samuel-ellison/Horizontal-Platform-Mechanism/README.md

# Horizontal-Platform-Mechanism
MECH&AE 162A - Introduction to Mechanisms and Mechanical Systems - Final Project - UCLA 2019

Professor Majlessi

This is NOT to be used for future students trying to complete the class. The purpose is to backup my work and for fututre reference.
