samuel-ellison/Horizontal-Platform-Mechanism/Ellison_Samuel_Report_Fall2019.pdf

Samuel Ellison
204977052
12/13/2019

## MAE 162A Final Project: Horizontal Platform Mechanism

(1) Mechanism Dimensions

The Horizontal Platform Mechanism is composed of two main vector loops: a four-bar linkage on the left, and another loop to describe the rest of the mechanism’s linkages. The first step in determining the dimensions was to look at the four-bar linkage. Taken alone, this kinematic chain resembles a Chebyshev linkage, of which the ratios of all links are proportionally related. The purpose and advantage of a Chebyshev linkage is that it will keep the midpoint of the coupler (link
3) vertically stable for a range of input angles. Therefore, if this linkage is used, the left leg of the platform will be satisfied. The appropriate ratios for a Chebyshev linkage are:

r1: r2: r3 = 4: 5: 2

and r2 = r4. Specifying any of these lengths will define the others. I chose to specify r1 = 810mm to fit within the 850mm horizontal limit at the bottom. The four bar Chebyshev linkage is then:

r1 = 810mm, r2 = r4 = 1012.5mm, r3 = 405mm

The Chebyshev linkage was constructed as a sketch in SolidWorks. The rest of the mechanism was added to the sketch and experimented with until the platform appeared to stay flat over a range of input angles. See the sketch and assembly construction of the mechanism below:

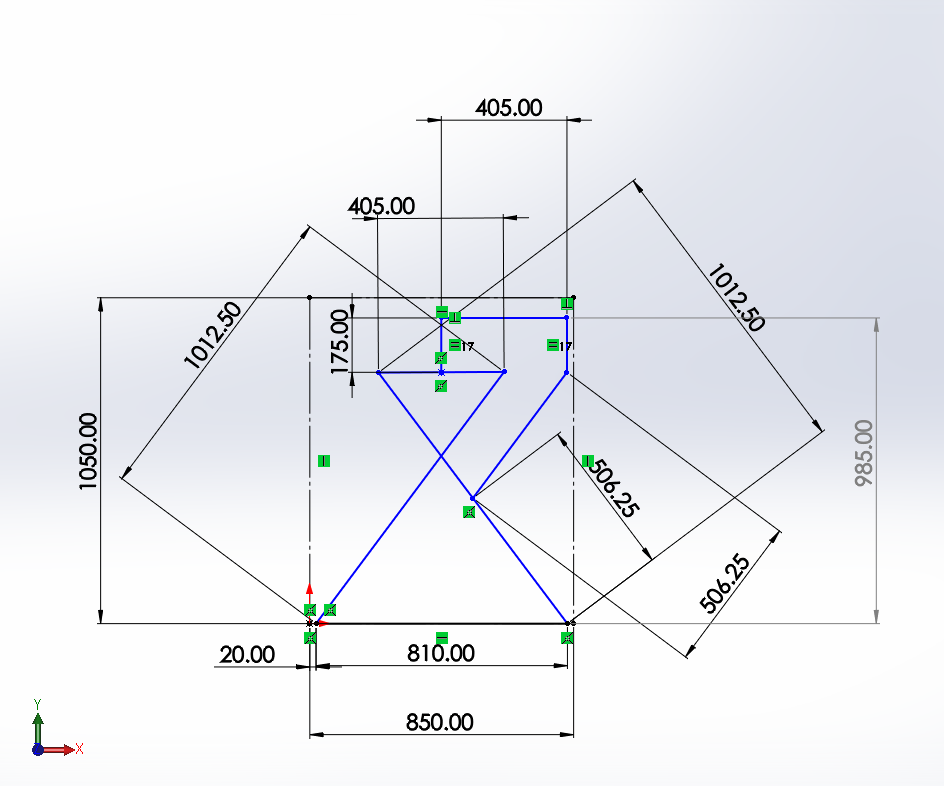
[picture p1: figure]

Figure 1: One Dimensional Sketch of Mechanism. All dimensions are in millimeters and were made into 3D linkages to the right. Note that link 5 bisects link 4 and is half its length, and that the length of the platform is the same as link 3.

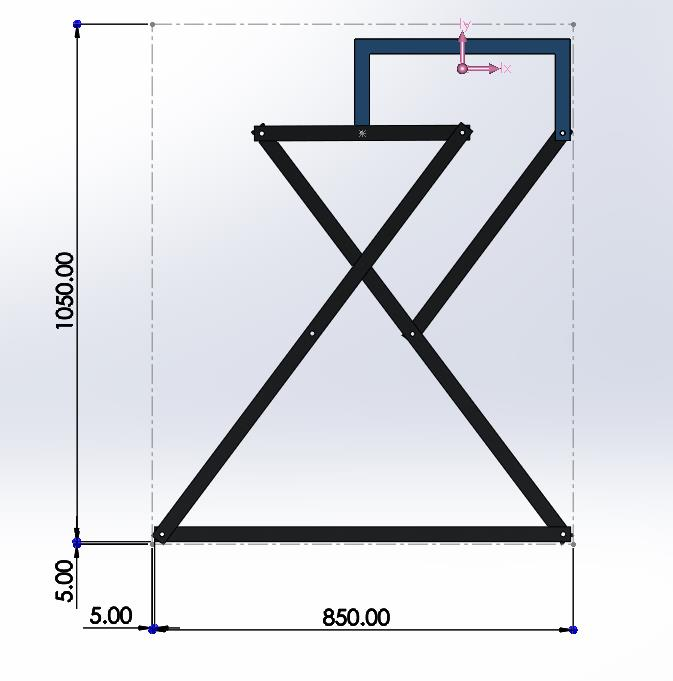
[picture p2: figure]

Figure 2: Planar View of 3D model of Mechanism. The Center of Mass of the Tabletop is shown as the pink origin. The rectangular outline encloses the entire mechanism for this position. Each link has a thickness and width of 30mm.

(2) The range of the input angle [θ2,min, θ2,max] was determined through trial and error. The angle was varied within the sketch (Figure 1) until the tabletop began to displace vertically/angularly. The range was entered into MATLAB to check the displacements to see if requirements were met (i.e. vertical displacement < 4mm, horizontal displacement > 850 mm). An ideal (but not unique) range was found to be:

θ2 = [36.87°, 96°]

θ2,min corresponds to the position at which the Chebyshev coupler and opposite leg are both oriented vertically, i.e. θ2,min = cos⁻¹

(

r1
r2

) = cos⁻¹

(

4
5

)

The entire Mechanism can be described with these two vector loops shown below:

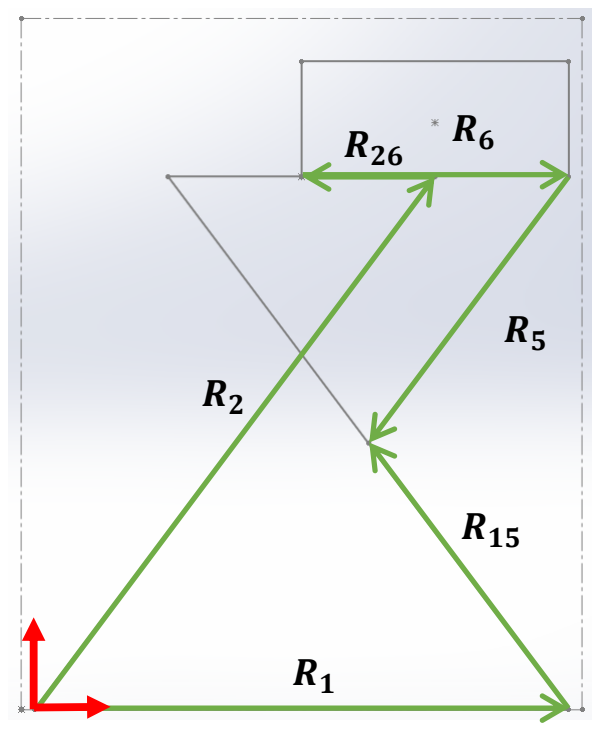
[picture p3: figure]
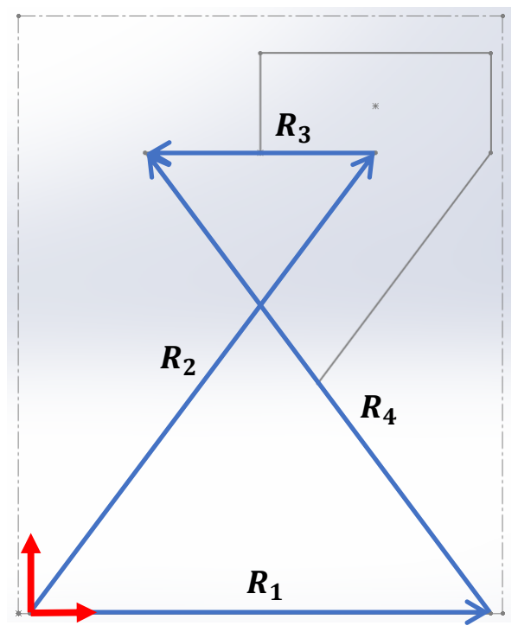
[picture p4: figure]

R2 + R3 − R4 − R1 = 0 | R2 + R26 + R6 + R5 − R15 − R1 = 0
r1 | r2 | r3 | r4 | r5 | r6 | r26 | r15
810mm | 1012.5mm | 405mm | 1012.5mm | 506.25mm | 405mm | C1 | C2
θ1 | θ2 | θ3 | θ4 | θ5 | θ6 | θ26 | θ15
0° | Input | Unknown | Unknown | Unknown | Unknown | C3 | C4

Where the Constraints are:

C1: | r26 = 0.5r3 | C2: | r15 = 0.5r15 | C3: | θ26 = θ3 | C4: | θ15 = θ4

Thus, a system of four equations and four unknowns was constructed and solved using MATLAB for every position of the input angle over its interval. Two separate Newton’s method iterations are used; the first uses the first vector loop to determine θ3 and θ4, and the second uses these values and determines θ5 and θ6. However, this is not sufficient to determine the displacement of the platform’s center of mass.

Once the position of the platform’s center of mass was determined, a new vector with constant properties was used to find its location from the endpoint of R26. See the appendix for a more detailed computation of the center of mass. The plots below illustrate the platform’s movements.

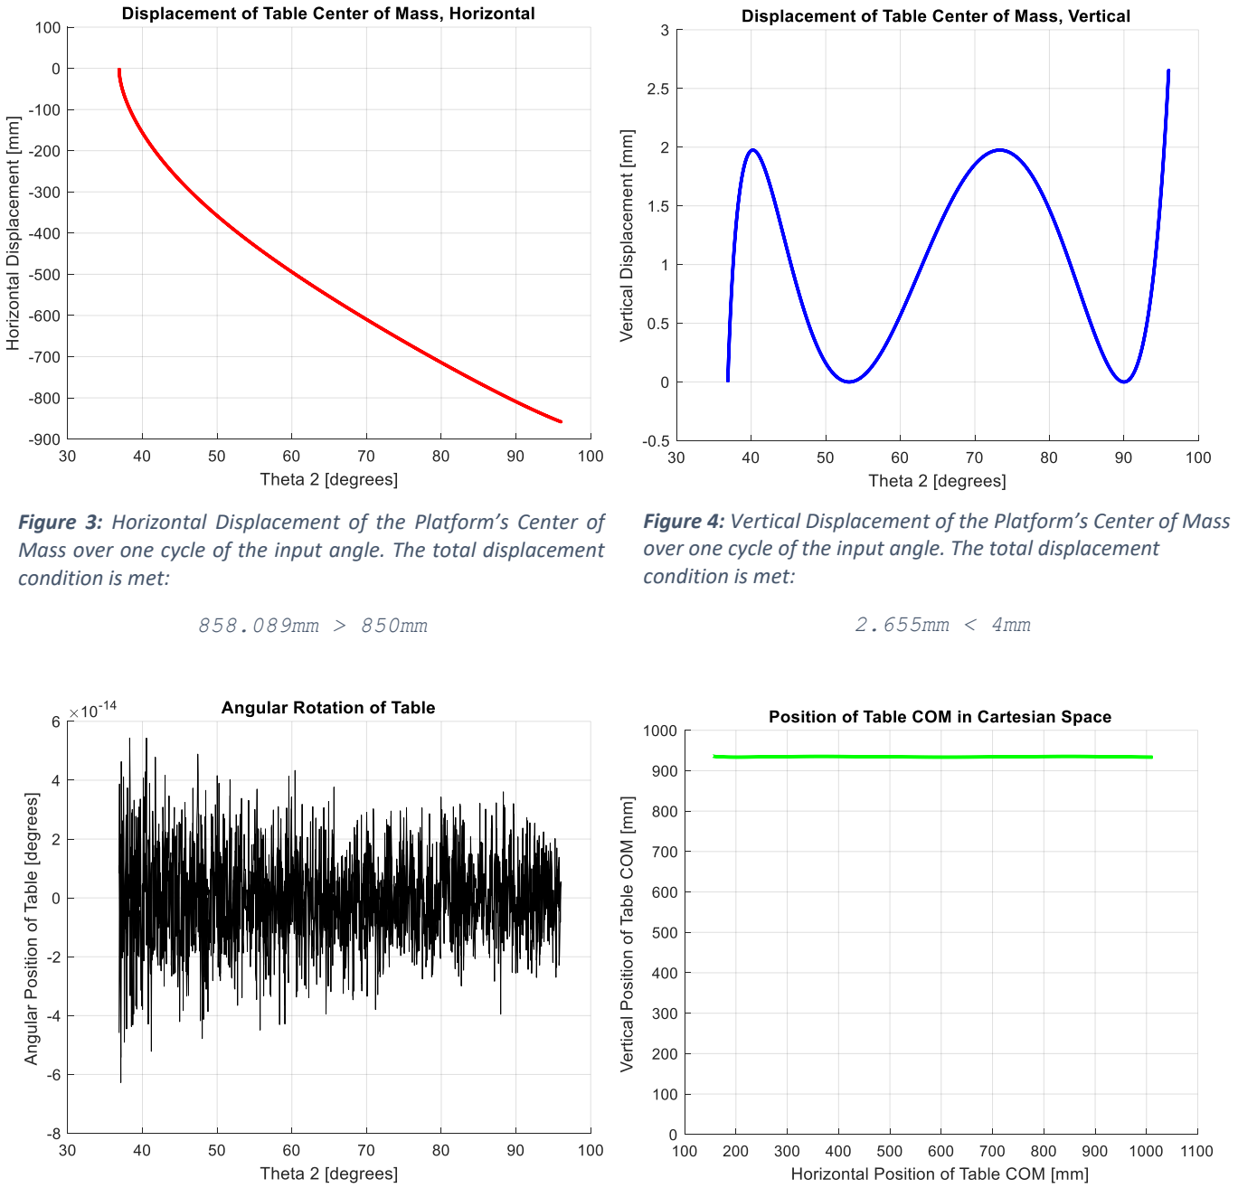
[picture p5: figure]
condition is met:

Figure 3: Horizontal Displacement of the Platform’s Center of Mass over one cycle of the input angle. The total displacement

Figure 4: Vertical Displacement of the Platform’s Center of Mass over one cycle of the input angle. The total displacement

Figure 5: Angular Displacement of the Platform’s Center of Mass over one cycle of the input angle. The total displacement condition is met:

1.171e-13 < 1°

Figure 6: Visualization of the overall position of the platform COM in space. The axes are scaled to emphasize that the vertical displacement is seemingly negligible.

The motor drives the angular position, velocity, and acceleration of link 2 over time according to:

θ2

(t) =

θ2,max − θ2,min
2

sin(wt) +

θ2,max + θ2,min
2

,t ∈ [0,

6π
w

] sec

dθ2
dt = ω2

(t) = w

θ2,max − θ2,min
2

cos(wt)

d

2θ2
dt

2 = α2

(t) = −w

2

θ2,max − θ2,min
2

sin(wt)

Where w = 1°/s = π/180 rad/s. The interval is 3 full cycles, or t ∈ [0,1080] sec. To determine the Torque applied to link 2 as a function of time, the Power Equation was used:

P(t) = τ(t)ω2(t) =

dT
dt +

dU
dt

dT
dt = ∑Aj
(t)ω2

(t)α2

(t)

6

j=2

+∑Bj
(t)ω2

(t)

3

6

j=2

Aj

(t) = mj(xGj

′2 + yGj

′2 ) + IGjθj

′2

Bj

(t) = mj(xGj

′
xGj

′′ + yGj

′ yGj

′′ ) + IGjθj

′θj

′′

dU
dt = ∑mjgyGj
′
(t)ω2

(t)

6

j=2
mj = ρAVj

IGj =

mj
12 (W² + rj

2
)

The four unknown output angles from above were recalculated using Newton-Raphson for the time dependent input angle. All kinematic coefficients (linear and angular) were evaluated again using Newton-Raphson on the first and second derivatives of the vector loops. These coefficients are all time dependent according to the input angle. The density of the link material (Aluminum) is ρA = 2698.9 kg/m³, and the width of each link is W = 30mm.

Putting everything together:

τ(t) = ∑Aj
(t)α2

(t)

6

j=2

+∑Bj
(t)ω2

(t)

2

6

j=2

+∑mjgyGj
′
(t)

6

j=2
The MATLAB program generated the following plot for input Torque of the motor as a function of time over 3 full cycles of the input angle.

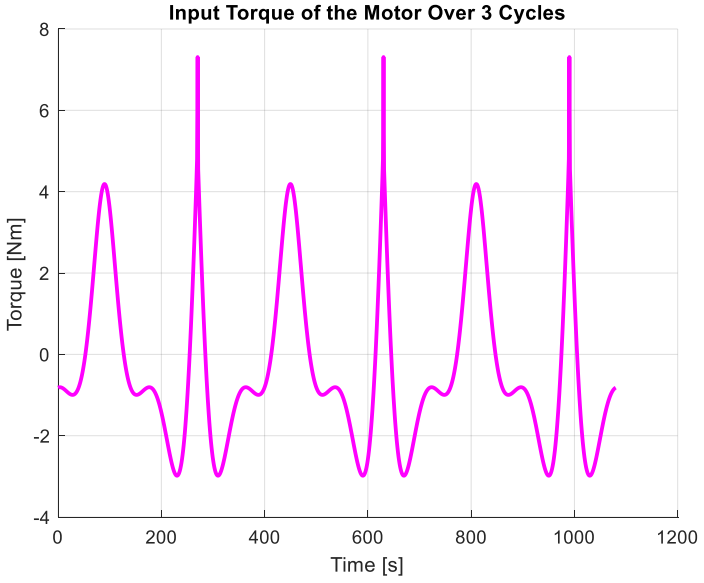
[picture p6: figure]

The table below summarizes the results of the simulation:

| Maximum Horizontal Displacement | Maximum Vertical Displacement | Maximum Angular Displacement
Value | 858.089mm | 2.655mm | 1.171E-13°
Requirement | x > 850mm | y < 4mm | θ < 1°
Requirement Met? | Yes | Yes | Yes
Table 1: Design Requirements and the simulation results. All conditions specified have been met.

Figure 7: Input Torque produced by Motor as a function of time. The torque appears to oscillate periodically with many local maxima and minima. The global maximum is 7.3097 Nm and global minimum is -2.9836 Nm. Therefore, the input Torque must change direction over time. The sharp peaks at the global maximum occur regularly over the three cycles, which corresponds to the time at which the mechanism changes its movement direction. The time between these peaks is equal to one full cycle.

## Appendix 1: Center of Mass Calculation

The platform takes the following two-dimensional shape:

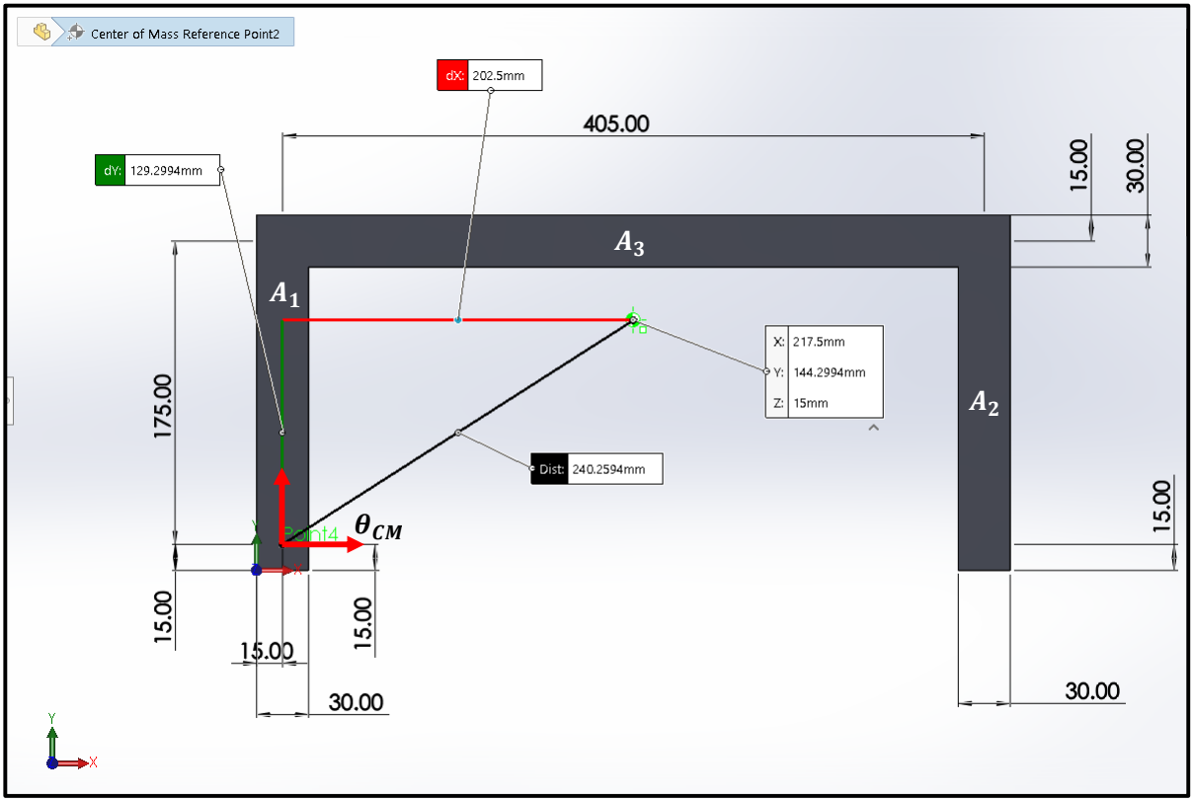
[picture p7: figure]
θCM

To calculate the Center of Mass, the platform was decomposed into three rectangles, each with their own centers. The following relation describes the positions of the COM (relative to the origin) of the entire platform with respect to the parameters of the rectangles:

xG =

A1x̅1 + A2x̅2 + A3x̅3
A1 + A2 + A3

=

(6150)(0) + (6150)(405) + (11250)(202.5)
6150 + 6150 + 11250 | = 202.5mm

yG =

A1y̅1 + A2y̅2 + A3y̅3
A1 + A2 + A3

=

(6150)(87.5) + (6150)(87.5) + (11250)(175)
6150 + 6150 + 11250 | = 129.3mm

To determine the positions of the center of mass over time with respect to the actual origin (placed at the lower joint of link 2), we need a vector D to describe its location since the platform is changing angles. The overall center of mass position is therefore:

xG6(t) = r2 cos(θ2(t)) + r26 cos(θ3(t)) + Dcos (θ6(t) + θCM)

yG6(t) = r2 sin(θ2(t)) + r26 sin(θ3(t)) + Dsin (θ6(t) + θCM)

Where D = √xG
2 + yG

2 = 240.26mm and θCM = tan⁻¹ yG
xG

= 32.56°

Figure 8: Platform Dimensions for Center of Mass Calculation. Note that the shape has been broken down into three separate rectangles, and the Origin is placed at the joint connecting the platform to the coupler. The COM calculation below is consistent with SolidWorks calculation. The joint holes are omitted because the MATLAB simulation is 1 Dimensional and therefore has no holes at joints. In 3D, these holes would have an effect on COM.
