samuel-ellison/Horizontal-Platform-Mechanism/FINAL_DESIGN.SLDASM

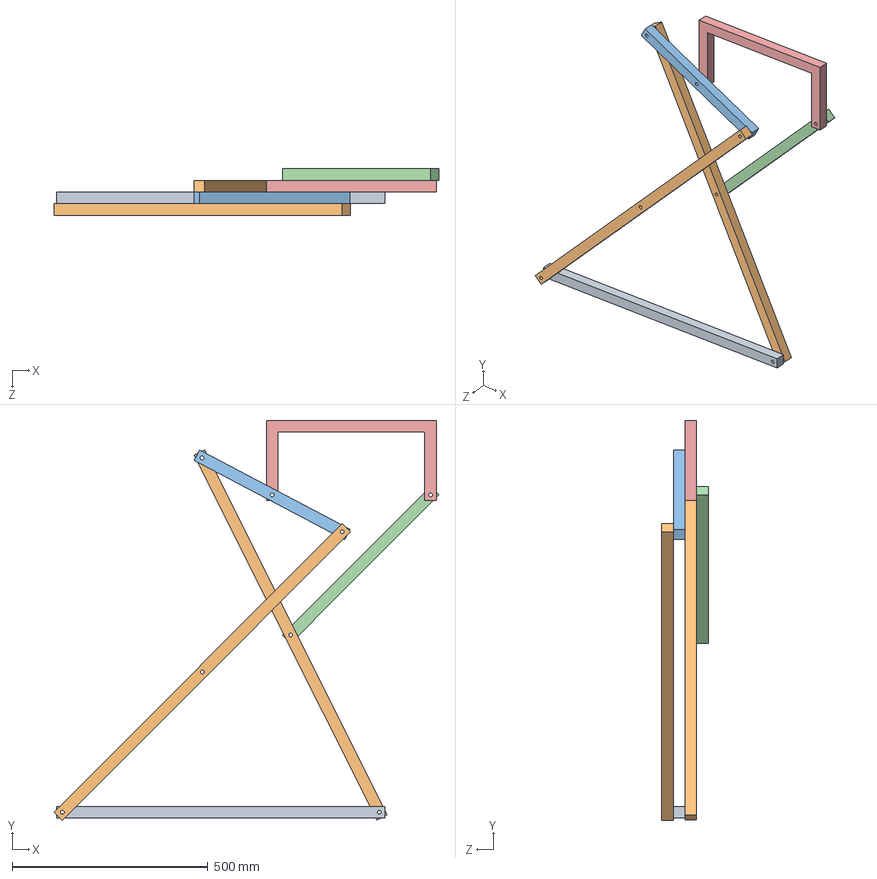
[picture p8: CAD file, 2019-12-17, last stored version]
FINAL_DESIGN.SLDASM
983.5 x 1022.3 x 120.0 mm
r1
r2_r4 x 2
r3
r5_r15
real table
